loggerhead-instruments/Metronome/Spec Sheets/430450200_sd.pdf

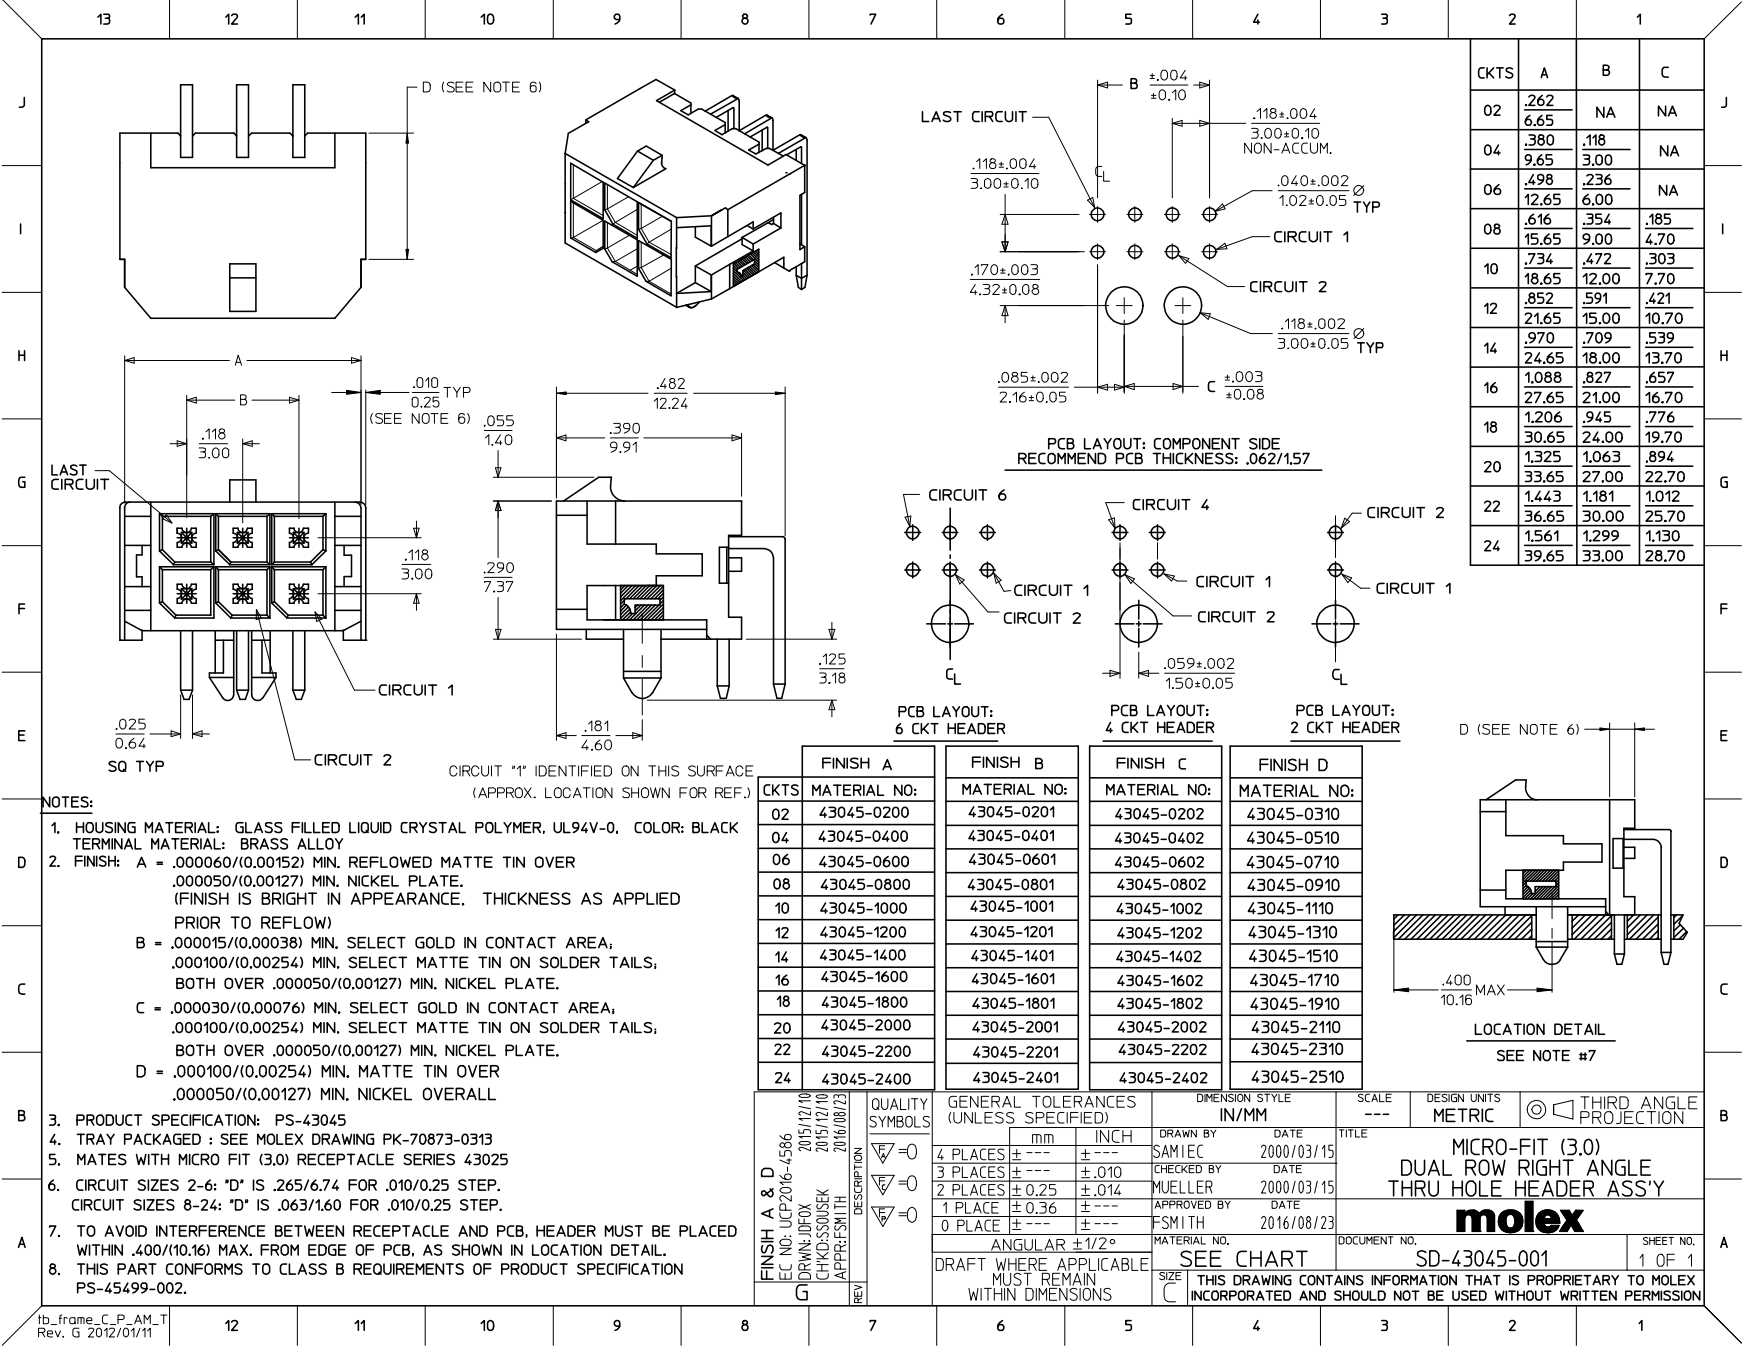
[picture p4: page 1]
