loggerhead-instruments/Metronome/Spec Sheets/430450213_sd.pdf

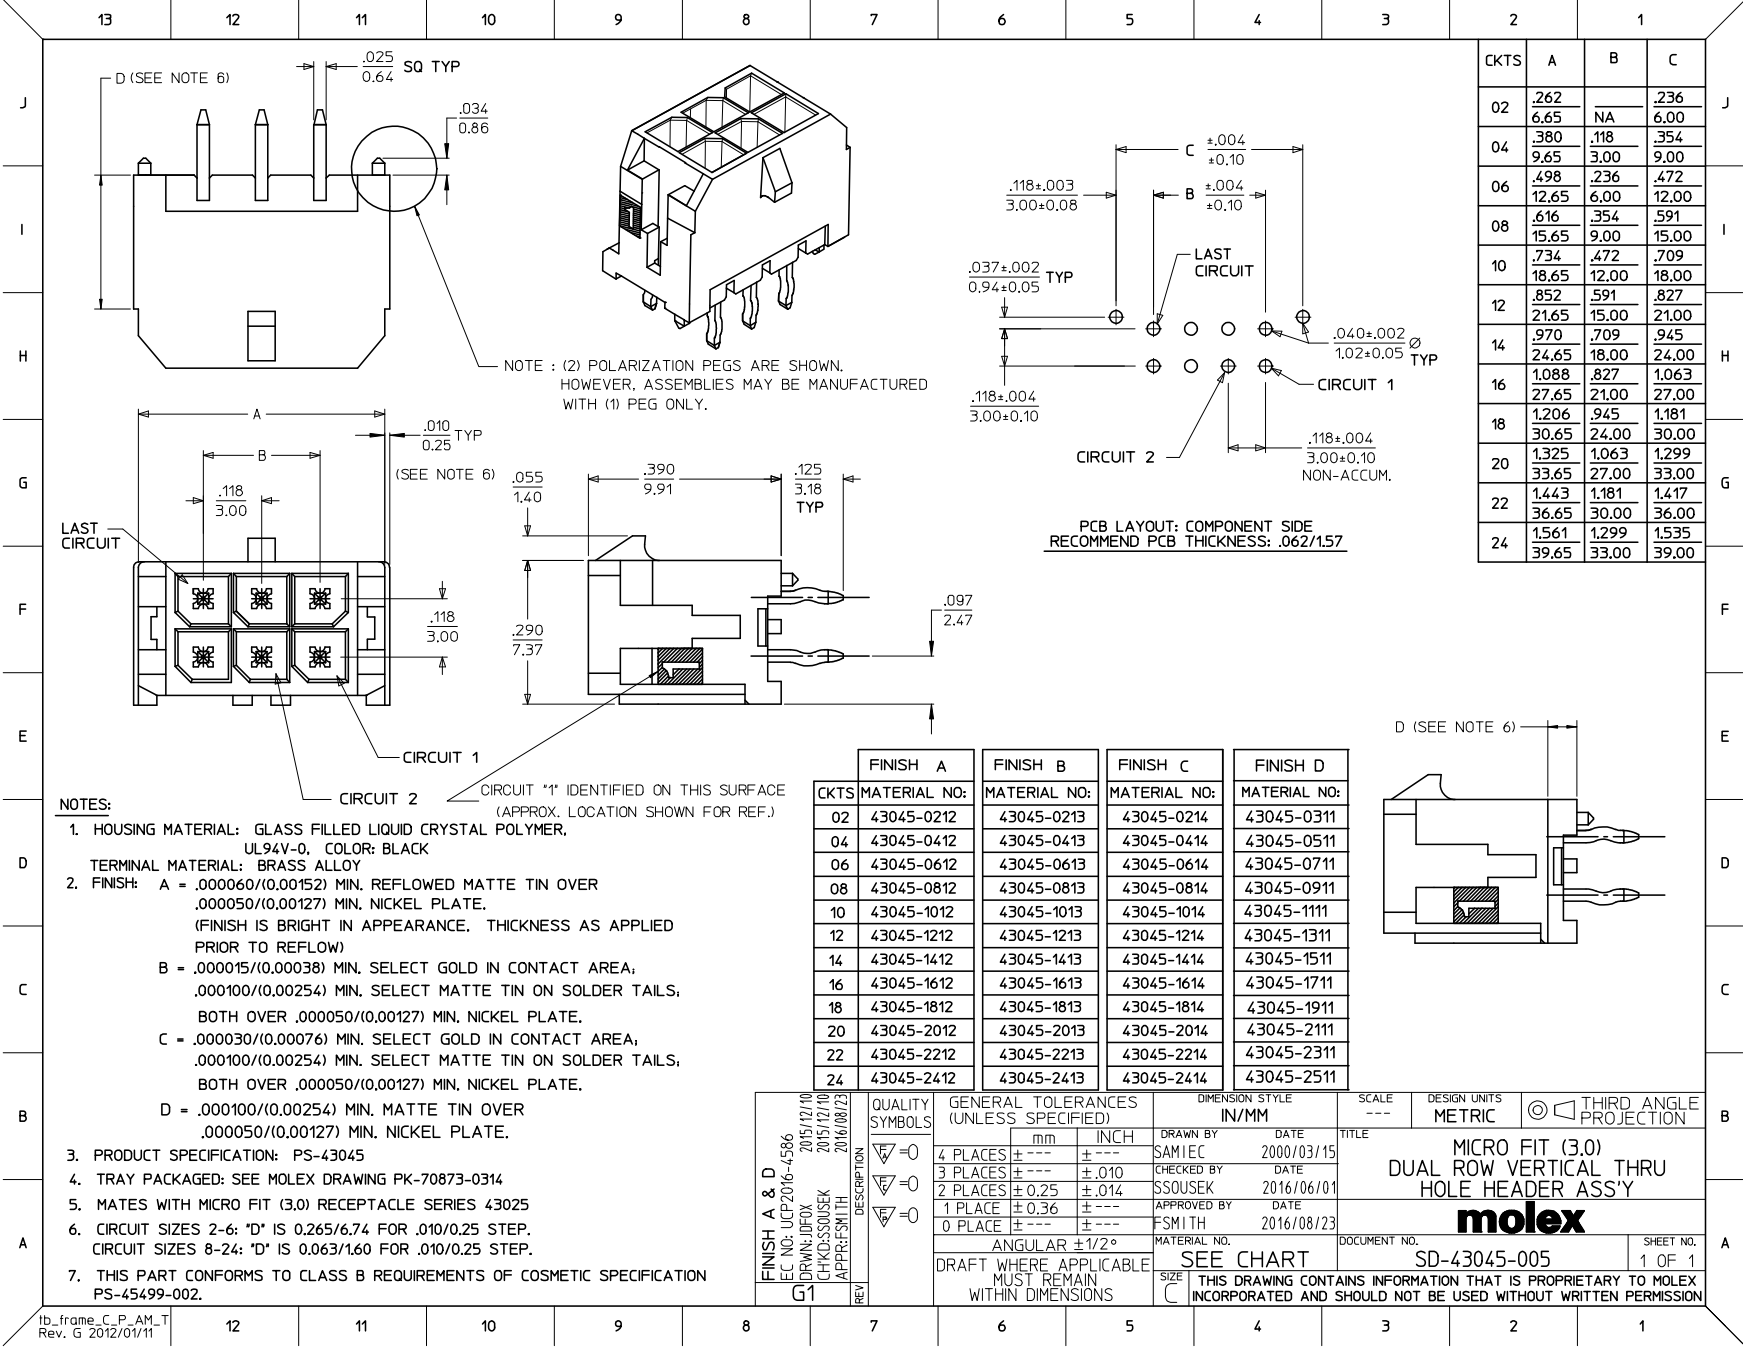
[picture p5: page 1]
