loggerhead-instruments/Metronome/(list of files, drawings)

Other design files:
Altium/OpenSwitch.PcbDoc
Altium/OpenSwitch.PrjPCB
Altium/OpenSwitch.SchDoc
Altium/OpenSwitch_Power.SchDoc
