loggerhead-instruments/Metronome/(commit log)

2019-09-18 Initial PCB layout
    [OpenSwitch.PcbDoc, OpenSwitch.SchDoc]
2019-10-28 small PCB fixes
    [OpenSwitch.PcbDoc, OpenSwitch.PrjPCB, OpenSwitch.SchDoc, OpenSwitch_Power.SchDoc]
2020-01-13 relay switching
2020-01-14 fix schedule file read
    [Metronome.ino, cmd.ino]
2020-01-14 voltage divider up to 12V input
    [OpenSwitch.SchDoc]
2020-01-14 voltage read averaging, suuport 12V input
2020-01-14 comment prints
2020-01-14 power down display
2020-01-15 log failed GPS fix
    [Metronome.ino]
2020-01-15 fix schedule.txt
    Require file
    Error if no schedule.txt
    Fix issues with parsing lines
    [Metronome.ino, cmd.ino]
2020-01-27 reset timeout if UP or DN pressed
    [display.ino]
